18368311581/smart-reminder/hardware/3d/all.3mf

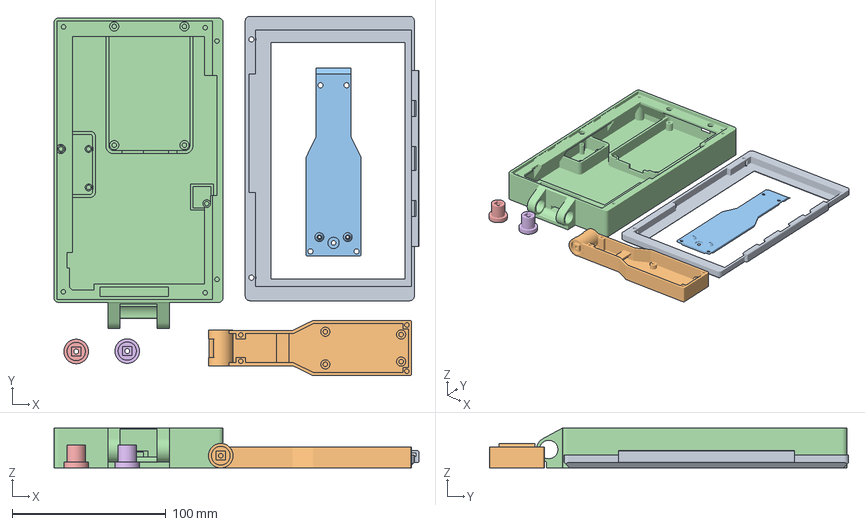
[picture p18: CAD file, 2026-10-20]
hardware/3d/all.3mf
237.3 x 233.8 x 26.0 mm
Part6.stl
Part8.stl
Part10.stl
Part5.stl
Part7.stl x 2
