18368311581/smart-reminder/firmware/source/Inc/page_deleted.h

#ifndef __PAGE_DELETED_H_
#define __PAGE_DELETED_H_
#include "icons.h"
#include "data_base.h"
void Page_deleted_draw(void);
void Page_deleted_process(uint16_t x,uint16_t y);
void page_deleted_show_update(void);
#endif
