18368311581/smart-reminder/firmware/source/Inc/page_entering.h

#ifndef __PAGE_ENTERING_H_
#define __PAGE_ENTERING_H_
#include "icons.h"
#include "time_clocks.h"
#include "data_base.h"
void Page_entering_draw(void);
void Page_entering_process(uint16_t x,uint16_t y);
#endif
