18368311581/smart-reminder/firmware/source/Inc/page_home.h

#ifndef __PAGE_HOME_H_
#define __PAGE_HOME_H_
#include "icons.h"
#include "data_base.h"
void Page_home_draw(void);
void Page_home_process(uint16_t x,uint16_t y);
void page_home_show_update(void);
void page_warning_jump(Item_class* item);
#endif
