18368311581/smart-reminder/firmware/source/Inc/page_warning.h

#ifndef __PAGE_WARNING_H_
#define __PAGE_WARNING_H_
#include "icons.h"
#include "data_base.h"
#include "page_home.h"
void page_warning_show_update(void);
void Page_warning_draw(void);
void Page_warning_process(uint16_t x,uint16_t y);
#endif
